BrockCruess/3D-Printing/AnkerMake M5 Mods/README.md

Do you dream of a dead silent idle and fans quieter than the motors during printing?

You've come to the right place.

Do all of these mods to achieve an AnkerMake M5 that can print right beside you and not bother you. Cooling will actually be improved as well.
