BrockCruess/3D-Printing/AnkerMake M5 Mods/Quieter 40mm Mainboard Fan/40mm Mainboard Fan Adapter.stl

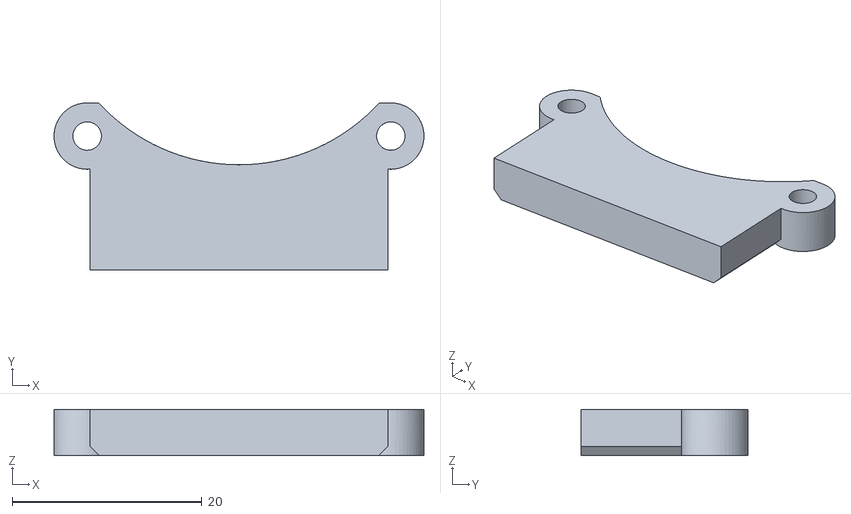
[picture p1: CAD file, 2023-11-06]
AnkerMake M5 Mods/Quieter 40mm Mainboard Fan/40mm Mainboard Fan Adapter.stl
39.0 x 17.6 x 4.90
