BrockCruess/3D-Printing/AnkerMake M5 Mods/M5 Spool Sleeve/1kg Filament Spool Sleeve 55mm ID.stl

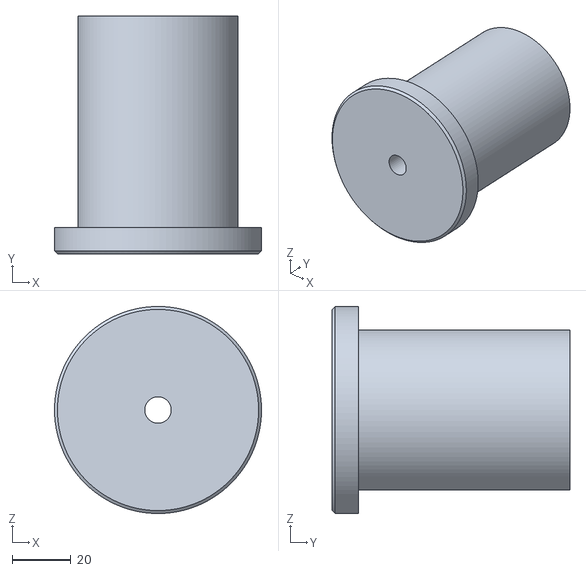
[picture p2: CAD file, 2023-11-06]
AnkerMake M5 Mods/M5 Spool Sleeve/1kg Filament Spool Sleeve 55mm ID.stl
70.5 x 81.0 x 70.5
