BrockCruess/3D-Printing/AnkerMake M5 Mods/Quieter Model Cooling Fan/5015 Model Fan Duct.stl

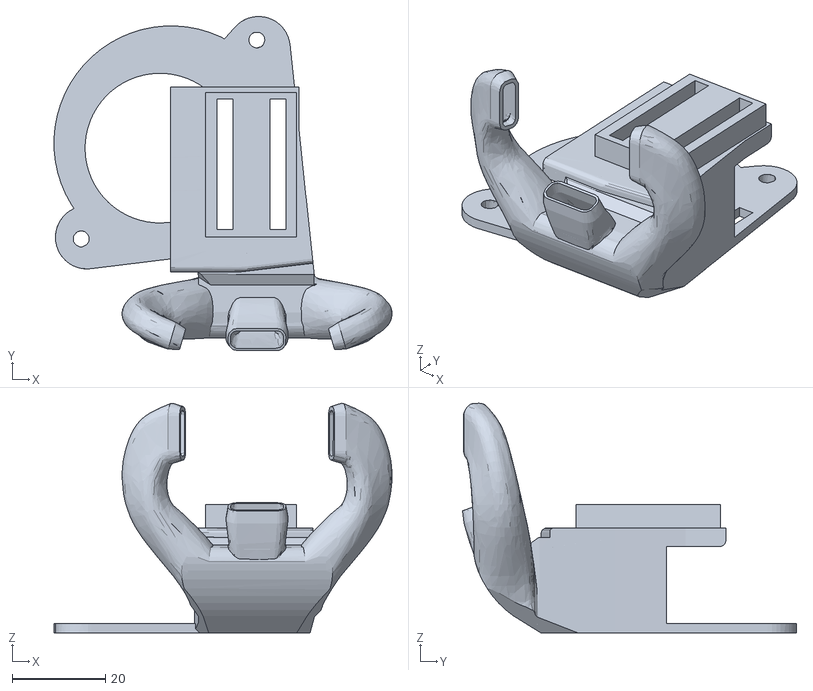
[picture p3: CAD file, 2023-11-07]
AnkerMake M5 Mods/Quieter Model Cooling Fan/5015 Model Fan Duct.stl
72.5 x 71.6 x 49.2
