BrockCruess/3D-Printing/AnkerMake M5 Mods/Quieter Throat Fan/Noctua 40mm Throat Fan Adapter.stl

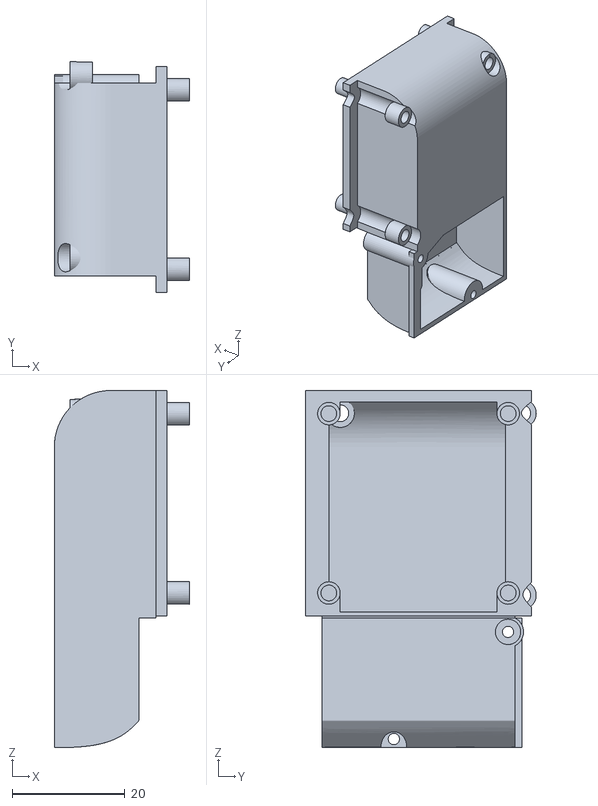
[picture p4: CAD file, 2023-11-07]
AnkerMake M5 Mods/Quieter Throat Fan/Noctua 40mm Throat Fan Adapter.stl
24.0 x 40.9 x 63.3
