BrockCruess/3D-Printing/BeeLink SER3 120mm Fan Mod/Top Retainer.stl

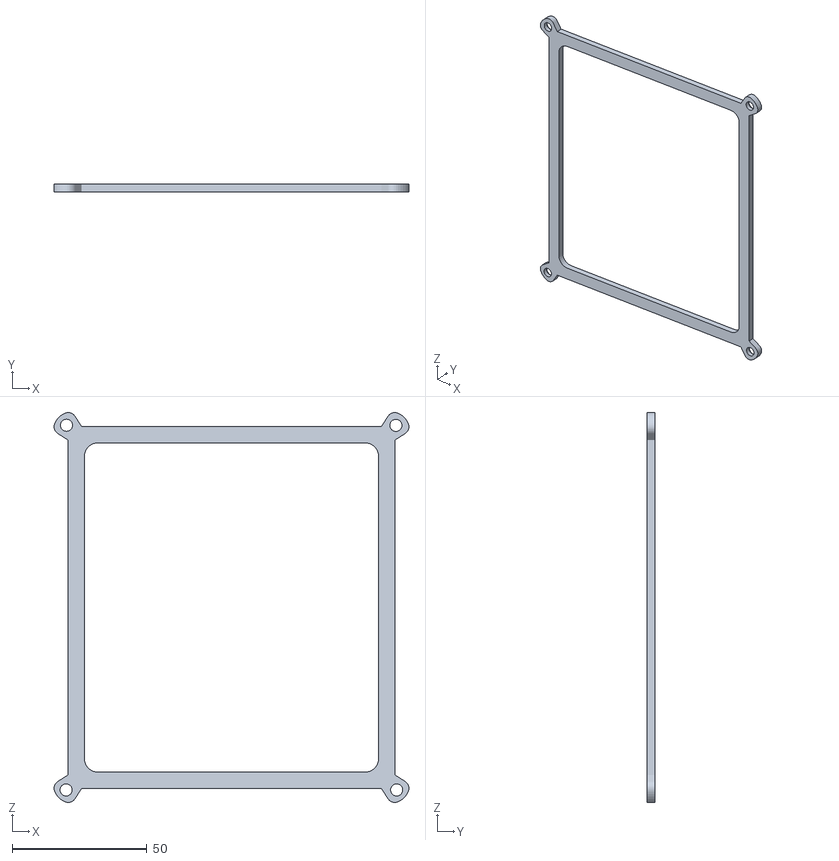
[picture p5: CAD file, 2023-11-06]
BeeLink SER3 120mm Fan Mod/Top Retainer.stl
131.5 x 3.00 x 144.5
