BrockCruess/3D-Printing/AnkerMake M5 Mods/M5 Spool Sleeve/Locking Key.stl

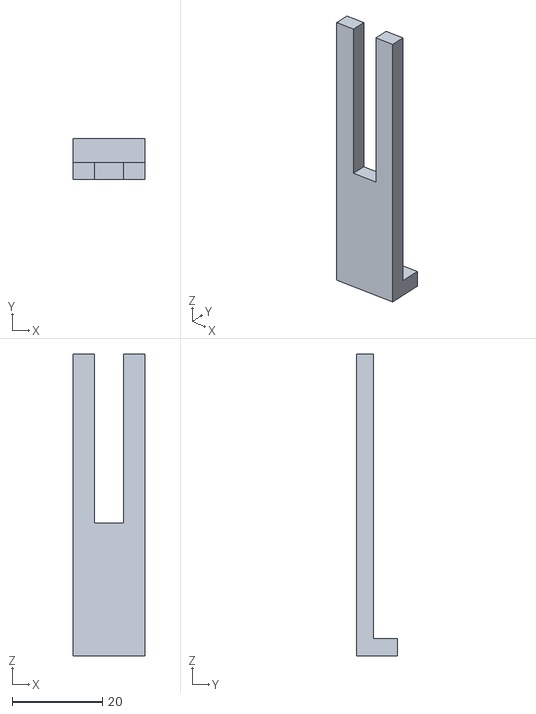
[picture p6: CAD file, 2023-11-06]
AnkerMake M5 Mods/M5 Spool Sleeve/Locking Key.stl
16.0 x 9.00 x 67.0
