BrockCruess/3D-Printing/BeeLink SER3 120mm Fan Mod/120mm Fan Bracket.stl

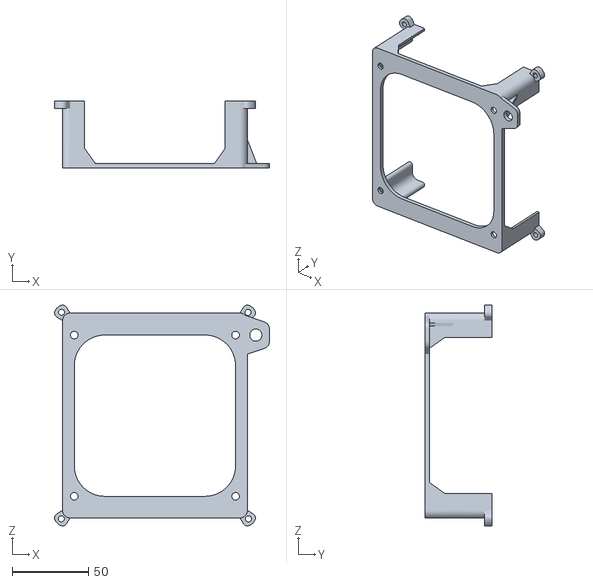
[picture p7: CAD file, 2023-11-06]
BeeLink SER3 120mm Fan Mod/120mm Fan Bracket.stl
140.7 x 44.0 x 144.5
